NadavBenda/robotic-backgammon/pc/README.md

# PC side

Talks to `firmware/board` over USB serial (no Wi-Fi). Needs `pip install pyserial opencv-python numpy` (and `torch` for the pixel network of train_detector.py, optional).

**Folder:** the top level holds only the scripts you run (double-click) and their data
(`calib.json`, `layout.json`, `vision_model.json`, `captures/`, `games/`). All internal code is in
`lib/`; each script adds `lib/` to the import path by itself, so nothing else is needed.

| run this | for |
|---|---|
| `game.py` | a whole game, in the browser |
| `console.py` | type commands to the board (H, G x y, M 1, C, ?) |
| `calibrate.py` | camera calibration (`test` mode: click -> the magnet goes there) |
| `teach_layout.py` | fit the board map to the real board in 4 clicks |
| `place_opening.py` | set up the opening position with the cart showing where |
| `place_trays.py` | put all 30 checkers in the bear-off trays, the cart showing where |
| `arrange_opening.py` | the robot sets up the opening from the trays by itself |
| `collect.py` | labelled photos for checker detection: the robot moves checkers (columns, bar, bear-off trays; mostly where the dataset is thin) and photographs each position (saved in dataset/, not uploaded) |
| `train_detector.py` | teaches the learned checker detector from those photos, compares it with norm, saves detector.json (used only when vision = learned) |
| `move.py` | move single checkers by clicking, with planned paths |
| `swap.py` | demo: swap two checkers |
| `drag_test.py` | find the fastest drag speed that holds |
| `capture.py` | take photos |

The list below describes every file; the ones not in the table above are in `lib/`.

- `board.py`: `Board` class. Each call sends one command and waits for `DONE` (or raises `BoardError` on `ERR` / timeout), so commands never overlap. Units are mm.
- `console.py`: **the single place to control the board** (instead of the Serial Monitor). Type `H`, `G 100 200`, `M 1`, `C`, `?`; `C` saves and shows the photo. Normal mode shows results and warnings; type the toggle word (`DEV_TOGGLE` at the top, default `dev`) for developer mode with every board log line and timings.
- `gnubg.py`: GNU Backgammon as the move engine. `best_move(board, dice)` takes the 26-number board (`set board simple` format, from the side on roll) and returns `[Step(frm, to, hit)]` (BAR=25, OFF=0). `hit=True` = move the opponent checker to the bar first. Path to `gnubg-cli.exe` and strength (`PLIES`) at the top.
- `calibrate.py` + `lib/calib.py`: camera calibration by the robot itself. One checker rides on the magnet over a 6x6 grid; at each point a photo is taken and the checker found (Hough circle, you confirm with Enter or click). The green ellipse is where the round bottom of the checker should appear there: click so it sits on the bottom. Fits pixel <-> mm (lens distortion + perspective + mirror) into `calib.json` and prints the error. `py calibrate.py test`: click a checker in the photo and the magnet goes there.
- `swap.py`: finds two checkers in a photo and swaps them through a free spot beside them (A -> spot, B -> A, spot -> B), for a demo. `--times 6` swaps back and forth, `--auto` skips the window when exactly two are found. Stops `--overshoot 3` mm past the target before letting go; `--wiggle 3` makes a small circle after grabbing.
- `drag_test.py`: click a checker and a target; drags it once per profile, alternating A->B / B->A, at 120/160/200/250 mm/s and 300/800 mm/s^2 (skips higher accelerations once one fails), and after each drag shows a photo where you click the checker (no automatic detection), then lets you test the next checker. Prints a table per checker (+ `captures/drag_test.csv`) and leaves the fastest profile that held for all of them set on the board.
- All scripts home only when the board says `HOMED 0` (after a reset). Speeds live only in the firmware: drag (magnet on) 180 mm/s, 800 mm/s^2; free (magnet off) 150 mm/s, 1200 mm/s^2 from a 40 mm/s start; `M 0` waits 250 ms so a checker is let go before the next move. Change them without flashing with `P v a` / `F v a` in console.py (until reset).
- `paths.py`: `plan(start, goal, others)` returns the corners of a drag path whose checker keeps 30 mm (centre to centre) from every other checker (A* on a 5 mm grid, then corners cut, so usually 1-3 straight lines); `drag(b, path)` drives it with the magnet on and a 3 mm overshoot. Raises `NoPath` when the checkers block every way.
- `place_opening.py`: sets up the opening with no graphics on the glass: the cart drives under each place, you put a checker above it and press Enter, the magnet pulses to centre it.
- `move.py`: click all checkers once, then pick a checker and a goal; shows the planned path, drives it, and you click where it landed. Counts moves within 5 mm and moves that disturbed a neighbour (the 10/10 test).
- `helpers.py`: photo, circle finder, the click window and magnet-on shared by the scripts.
- `ui.py`: text strip above the photo, the expected checker-bottom ellipse, and `keep_open()` so a double-clicked script waits for Enter at the end (also after an error).
- `capture.py`: press Enter to grab a JPEG (UXGA 1600x1200) into `captures/` and show it (corrected top view once calib.json exists).

```python
from board import Board
with Board() as b:          # finds the ESP32 port by itself, or Board("COM5")
    b.home()
    b.move(100, 200)
    b.magnet(True); b.move(150, 200); b.magnet(False)
    jpeg = b.capture()
```

## Playing a whole game (12.11)

`py game.py` (double-click) opens a page in the browser: the board, the dice, the buttons and the
settings. Real board if it is connected, otherwise a simulator (to try everything without hardware).
Also from a phone on the same WiFi (the address is printed).

| file | what | options inside |
|---|---|---|
| `game.py` | turns, dice, reading the human's move, end of game, log in `games/<date-time>/` | mode: robot vs human / robot vs robot (demo) / watch (two people, the robot checks); human move: Done button / automatic (waits until the board shows a legal move) / pick it on the page and the robot moves it |
| `webui.py` | the page + terminal fallback (n, d, 52, ...) | |
| `rules.py` | legal moves, simple engine, find the move between two boards | engine: gnubg / simple / random |
| `layout.py` | where each checker goes, in mm (points, bar, bear-off trays, dice zone, park spot) | defaults from plan v4 fitted to 410x420; `teach_layout.py` fits it to the real board in 4 clicks |
| `vision.py` | board from one photo: colour of the rim around the steel bottom | scan (default) / slots / hough, + closest legal board |
| `dice.py` | the roll | digital / typed / camera (bottom face, 7 - pips) |
| `executor.py` | a move -> drags: on a hit the hitter waits next to the blot, the blot goes to the middle of the bar, then the hitter goes in; bear-off tray, paths | route: A* -> tight A* -> lane -> straight; `arrange()` sets up a position |
| `sim.py` | fake board: checkers follow the magnet, photos drawn through a fake camera | |
| `board_art.py` | `board_art.svg`, the board graphics at 1:1 from layout.json | |
| `lib/tests/` | `py lib/tests/test_rules.py`, `py lib/tests/test_sim.py` (whole game in the simulator) | |
