NadavBenda/robotic-backgammon/electronics/wiring_table.xlsx

Sheet: ESP32-S3
פין | אות | מחובר אל | צבע | הערה
GPIO 1 | X STEP | RJ45 → Shield D2 | כחול-לבן
GPIO 2 | X DIR | RJ45 → Shield D5 | כחול | LED כחול מהבהב, תקין
GPIO 41 | Y STEP | RJ45 → Shield D3 | חום-לבן
GPIO 42 | Y DIR | RJ45 → Shield D6 | חום
GPIO 21 | EN | RJ45 → Shield D8 | ירוק-לבן | LOW = מנועים פעילים
GPIO 39 | LIMIT X | RJ45 → מפסקי X- (2 בטור) | כתום-לבן | INPUT_PULLUP
GPIO 40 | LIMIT Y | RJ45 → מפסק Y- | כתום | INPUT_PULLUP
GPIO 47 | MAG | RJ45 → AOD4184 PWM | ירוק | PWM
GPIO 38 | VIO | בננה → Shield 5V pin | אדום | לוגיקת הדרייברים, 0.6mA. HIGH ראשון ב-setup
GND | GND | בננה → Shield GND | שחור | אדמה משותפת
USB-C | מתח + נתונים | מאריך 0.5 מ' → שקע בשפת המכסה → PC | אפור | אין 5V מהקופסה
FPC | מצלמה | OV3660, 75 מ"מ

Sheet: RJ45 + בננה
מס' גיד (T568B) | צבע | אות | ESP (מכסה) | יעד (קופסה)
1 | כתום-לבן | LIMIT X | GPIO 39 | מפסקי X-
2 | כתום | LIMIT Y | GPIO 40 | מפסק Y-
3 | ירוק-לבן | EN | GPIO 21 | Shield D8
4 | כחול | X DIR | GPIO 2 | Shield D5
5 | כחול-לבן | X STEP | GPIO 1 | Shield D2
6 | ירוק | MAG | GPIO 47 | AOD4184 PWM
7 | חום-לבן | Y STEP | GPIO 41 | Shield D3
8 | חום | Y DIR | GPIO 42 | Shield D6
בננה 1 | אדום | 3.3V | GPIO 38 | Shield 5V pin
בננה 2 | שחור | GND | GND | Shield GND

Sheet: CNC Shield V3
פין | אות | מחובר אל | צבע | הערה
D2 | X STEP | ESP GPIO 1 | כחול-לבן
D5 | X DIR | ESP GPIO 2 | כחול
D3 | Y STEP | ESP GPIO 41 | חום-לבן
D6 | Y DIR | ESP GPIO 42 | חום
D8 | EN | ESP GPIO 21 | ירוק-לבן
5V pin | VIO 3.3V | ESP GPIO 38 (בננה) | אדום | לא לחבר 5V!
GND (לוגיקה) | GND | ESP GND (בננה), AOD4184 GND, מפסקי גבול | שחור | נקודת אדמה משותפת
מחבר 12V + | 12V | שקע DC בפאנל + AOD4184 + | אדום | פיצול בבורג
מחבר 12V − | GND | שקע DC בפאנל + AOD4184 − | שחור | פיצול בבורג
X driver | מנוע | מנוע ימני | אפור | לפי Instructables
Y driver | מנוע | מנוע שמאלי | אפור

Sheet: AOD4184
פין | אות | מחובר אל | צבע | הערה
PWM | MAG | ESP GPIO 47 | ירוק | אופטו PC817C, עובד מ-3.3V. לא צריך נגד 10k
GND | GND (אות) | Shield GND (= GND של ה-ESP) | שחור | מבודד מ-−, לא לקצר
+ | 12V | מחבר 12V של ה-Shield, וגם + של האלקטרומגנט | אדום | שני חוטים באותו בורג
− | GND | מחבר 12V של ה-Shield (−) | שחור
LOAD | מיתוג | הרגל השנייה של האלקטרומגנט | שחור | 1N4007 על המגנט: פס ל-+

Sheet: מפסקי גבול
מפסק | רגל | מחובר אל | צבע | הערה
X- (זוג בטור) | COM של הראשון | ESP GPIO 39 (RJ45) | כתום-לבן | NO, בטור: מופעל רק כששניהם לחוצים
X- (זוג בטור) | NO של הראשון → COM של השני | בין המפסקים
X- (זוג בטור) | NO של השני | Shield GND | שחור
Y- | COM | ESP GPIO 40 (RJ45) | כתום
Y- | NO | Shield GND | שחור

Sheet: מפת פינים ESP
GPIO | מצב | שימוש
4–13, 15–18 | אסור | מצלמה
35–37 | אסור | Octal PSRAM
19, 20 | אסור | USB
0, 3, 45, 46 | להימנע | Strapping
43, 44 | להימנע | UART0
48 | להימנע | RGB LED
1, 2, 41, 42 | תפוס | מנועים
21 | תפוס | EN
39, 40 | תפוס | מפסקי גבול
47 | תפוס | מגנט
38 | תפוס | VIO דרייברים
14 | פנוי
