NadavBenda/robotic-backgammon/electronics/wiring.md

# חיווט: AI-bg

הגרסה הנוכחית (4.11.2026) נמצאת ב-`wiring_table.xlsx` (טבלה לכל כרטיס) וב-`wiring_diagram.png` (שרטוט).

סיכום ההחלטות (grill 4.11):
- ה-ESP מקבל מתח ונתונים מה-PC דרך USB-C. מאריך 0.5 מ' עד שקע בשפת המכסה. אין 5V מהקופסה, וה-Mini360 יצא מהמערכת.
- בין המכסה לקופסה: כבל רשת עם RJ45 coupler לאותות, ומחבר בננה 2-pin ל-3.3V ו-GND.
- VIO של ה-Shield (פין 5V) מקבל 3.3V מ-GPIO 38 של ה-ESP (מ-8.11; 0.6mA נמדד), ולא 5V. הקוד מדליק את 38 ראשון ב-setup.
- מפסקי גבול: X- = שני NO בטור על GPIO 39, ו-Y- על GPIO 40. המגנט על GPIO 47 (צמוד ל-EN על 21). מודול ה-AOD4184 מבודד (אופטו PC817C), עובד מ-3.3V, ולא צריך נגד 10k.
- פיצול ה-12V נעשה בבורג של ה-Shield, בלי Wago. אין נתיך ואין מתג: חיבור השקע בפאנל מדליק את המערכת.
- 1N4007 על המגנט, פס ל-+.
