NadavBenda/robotic-backgammon/electronics/wiring_diagram.png

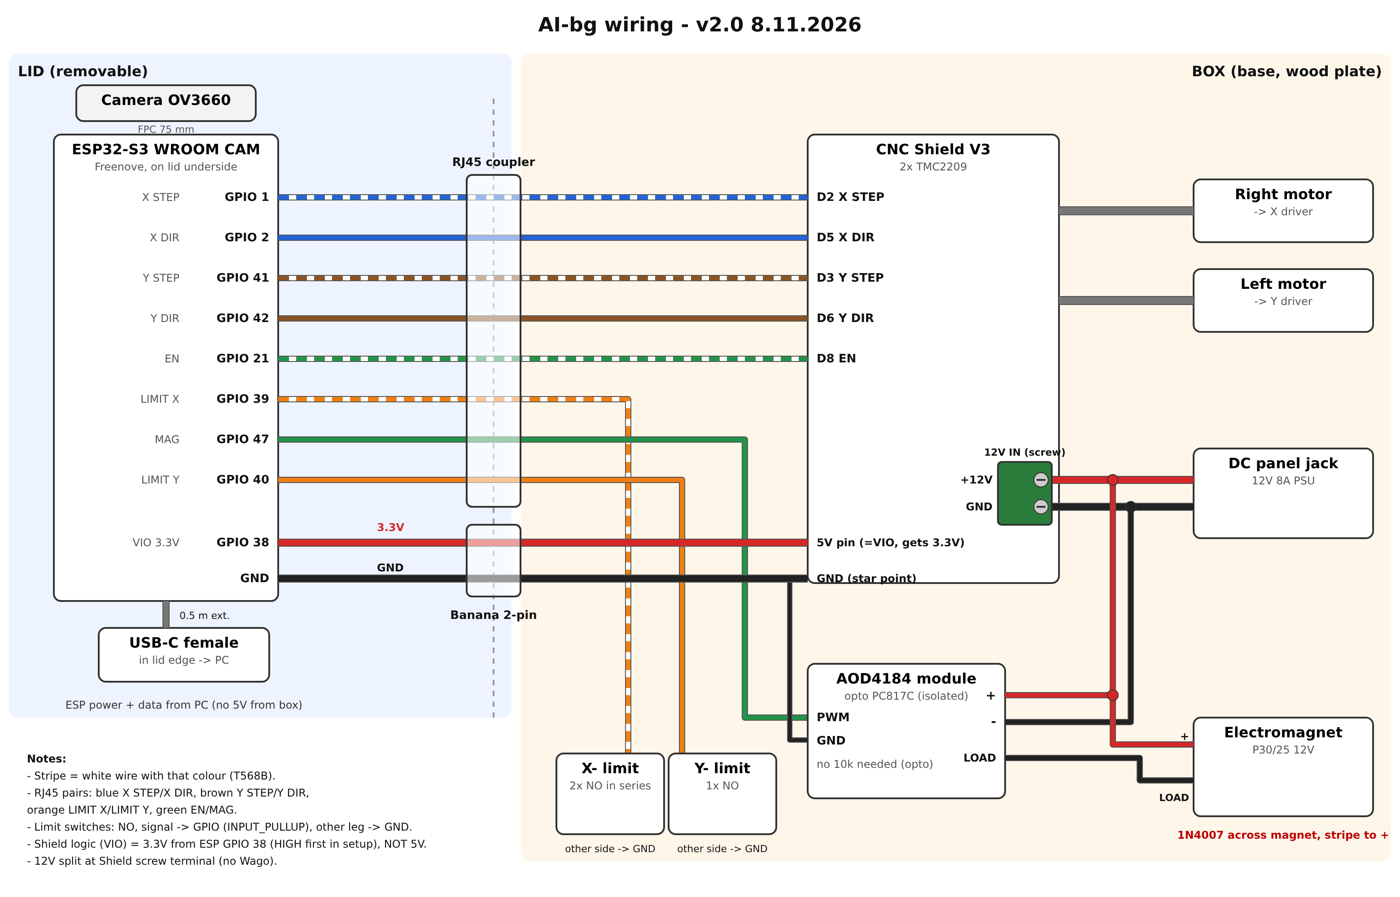
electronics/wiring_diagram.png
