NadavBenda/robotic-backgammon/(commit log)

2026-10-15 Add ESP32 firmware sketches (#1)
    Add circle_motors, home_LS and move_XY_using_serial sketches from the local ESP32 code folder, plus a short README with pins and serial commands.
    Claude-Session: https://claude.ai/code/session_01BqSRANh45VkKz8L2vsyHC4
2026-11-04 Move limit switches to GPIO 39/40 (15/16 are camera pins) (#2)
    Claude-Session: https://claude.ai/code/session_015WaiVMX3WZxhdmsv3QW5E3
2026-11-06 Add serial command to switch the electromagnet (#3)
    * Move limit switches to GPIO 39/40 (15/16 are camera pins)
    * Add M command to switch the electromagnet on GPIO 14
    ---------
    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
2026-11-06 Move electromagnet pin to GPIO 47 (#4)
    * Move electromagnet pin to GPIO 47 (next to EN on 21)
    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
2026-11-06 Add Magnet class with on-time timeout and heat budget (#5)
    Claude-Session: https://claude.ai/code/session_015WaiVLR25ZLCtFkV82XqwE
2026-11-06 Add BoardCheck.h: fail compile on wrong Arduino Tools settings (#6)
    * Add Magnet class with on-time timeout and heat budget
    * Add BoardCheck.h: fail compile on wrong Arduino Tools settings
    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
2026-11-07 Add board firmware (motion + magnet + camera over USB) and PC client (#7)
    * Add board firmware (motion + magnet + camera over USB, DONE/ERR protocol) and PC client
    Co-authored-by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
2026-11-07 Add PC console with normal/developer modes; warn on capture with magnet on (#8)
    * Add PC console wi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
2026-11-07 Add gnubg.py: GNU Backgammon move engine wrapper (#9)
    * Add PC console with normal/developer modes;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
2026-11-08 Power driver logic (Shield VIO) from GPIO 38 (#10)
    * Power driver logic (Shield VIO) from GPIO 38
    GPIO 38 is driven HIGH first in setup(),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
2026-11-08 Add wiring diagram and table (v2.0) (#11)
    GPIO 38 is driven HIGH first in setup(), before ST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
2026-11-09 Raise electromagnet max on-time from 10 s to 40 s (#12)
    * Add PC console with normal/developer mode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
2026-11-09 Set soft limits to the measured board edge (415 mm) (#13)
    * Add PC console with normal/developer mo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
2026-11-09 Homing: back off slowly until the limit switch releases (#14)
    * Add PC console with normal/develope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
2026-11-11 Add camera calibration by the robot (calibrate.py, calib.py) (#15)
    * Add PC console with normal/dev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
2026-11-11 calibrate: park the magnet away before each photo (#16)
    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
2026-11-11 calibrate: step aside 80 mm instead of going to a far corner (#17)
    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
2026-11-11 pc: swap.py, find two checkers and swap them (#18)
    * Add PC console with normal/developer modes; wa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
2026-11-11 Drag profile while the magnet is on, overshoot, bottom ellipse, readable windows (#19)
    * Add PC con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
2026-11-11 Drag profile default 120 mm/s, 300 mm/s²; P accepts up to 200 mm/s (#20)
    * Add PC console with nor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
2026-11-11 pc: drag_test.py, find the fastest drag profile that holds the checker (#21)
    * Add PC console with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
2026-11-11 Board edge x 410, y 420; shorter drag_test (#22)
    * Add PC console with normal/developer modes; warn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
2026-11-11 Home only when needed, park at 5,5 on close, faster drag_test (#23)
    * Add PC console with normal/de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
2026-11-11 drag_test: tolerance 30 mm, retry photo from park, save photos (#24)
    * Add PC console with normal/d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
2026-11-11 drag_test: click the checker after each drag; no park at 5,5 on close (#25)
    * Add PC console with n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
2026-11-11 drag_test: one drag per profile, alternating direction (#26)
    * Add PC console with normal/developer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
2026-11-11 drag_test: speeds 120-250, accels 300/800 (#27)
    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
2026-11-12 Drag paths that avoid other checkers (paths.py) + move test (move.py) (#28)
    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
2026-11-12 Release delay and two speed profiles in firmware (#29)
    * Add PC console with normal/developer modes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
2026-11-12 Whole game: rules, layout, vision, dice, executor, simulator, game page (#30)
    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
2026-11-12 sim: hand placement never overlaps another checker (#31)
    * Add PC console with normal/developer mod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
2026-11-12 Drag default 180/800 (firmware + PC) (#32)
    * Add PC console with normal/developer modes; warn on ca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
2026-11-12 place_opening.py: robot shows where each opening checker goes (#33)
    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
2026-11-12 Longer grab/release, top-down view after calibration (#34)
    * Add PC console with normal/developer m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
2026-11-12 capture.py: main guard (#35)
    * Add PC console with normal/developer modes; warn on capture with mag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
2026-11-12 Top view in every photo window, UXGA camera, roomier drag paths (#36)
    * Add PC console with normal/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
2026-11-12 Tidy pc/: scripts at the top, internal code in pc/lib (#37)
    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
2026-11-12 Release kick after M 0, calibration error map, park for calibration photos (#38)
    * Add PC console w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
2026-11-12 Round the corners of drag paths into short arcs (#39)
    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
2026-11-12 Corners: one short cut instead of a 3-point arc (#40)
    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
2026-11-12 Retake broken camera frames (#41)
    * Add PC console with normal/developer modes; warn on capture wit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
2026-11-12 Restore helpers.find_circles; test that every script imports (#42)
    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
2026-11-12 calibrate: grid from 0,0 to the travel limits (#43)
    * Add PC console with normal/developer modes; w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
2026-11-12 Release: overshoot 5 mm, back onto target, settle 0.4 s (#44)
    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
2026-11-12 Photo park spot: lane centre at y max (#45)
    * Add PC console with normal/developer modes; warn on c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
2026-11-12 All scripts park at (205, 420) for photos (#46)
    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
2026-11-12 Magnet-off moves go around the checkers (#47)
    * Add PC console with normal/developer modes; warn on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
2026-11-12 Vision: "norm" method as game default; save images on Hebrew paths (#48)
    * Add PC console with norm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
2026-11-12 Vision: read moves by change; auto camera-shift fix (#49)
    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
2026-11-12 Vision: safer camera shift and read-by-change acceptance (#50)
    * Add PC console with normal/develop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
2026-11-12 game: Learn colours button when needed (#51)
    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
2026-11-12 Hit order, bar in the middle, fix the reading on the page (#52)
    * Add PC console with normal/develo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
2026-11-13 norm: one colour per point, bar/off colour by place (#53)
    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
2026-11-13 CH: one full-resolution (QXGA) capture (#54)
    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
2026-11-13 calibrate: short step aside (40 mm out in y) for each photo (#55)
    * Add PC console with normal/deve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
2026-11-13 calibrate: good guess from the first point (#56)
    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
2026-11-13 calibrate: y≈0 row steps 40 mm inward (#57)
    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
2026-11-13 calibrate: photo position as before 12.11 (#58)
    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
2026-11-13 place_opening: go around placed checkers (#59)
    * Add PC console with normal/developer modes; warn o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
2026-11-13 collect.py: robot-made labelled photos for checker detection (#60)
    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
2026-11-13 Learned checker detector: train_detector.py + lib/learned.py (#61)
    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
2026-11-13 Pixel network (PyTorch) that also gets the computed features (#62)
    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
2026-11-13 Magnet-off travel keeps more room from checkers (#63)
    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
2026-11-13 Circle detection as a detector input + pixels-only control (#64)
    * Add PC console with normal/devel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
2026-11-13 Board drawing over every corrected top view (#65)
    * Add PC console with normal/developer modes; war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
2026-11-13 collect.py: show the next drag before each move (#66)
    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
2026-11-13 train_detector: mistake breakdown, seed spread, both nets together (#67)
    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
2026-11-13 collect: detector second opinion, moves where data is thin, bar and trays; lighter board drawing (#68)
    Claude-Session: https://claude.ai/code/session_015WaiVLR25ZLCtFkV82Xq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
2026-11-13 collect: the robot puts a pushed checker back by itself (#69)
    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
2026-11-13 Fewer stops per path; collect: mark what moved, crash log, state before each drag (#70)
    * Add PC co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
2026-11-13 Training stops early; quick training by default; sharp corners cost like any corner (#71)
    * Add PC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
2026-11-14 Game: vision default learned; only learned and norm offered; quick training trains learned only (#72)
    Claude-Session: https://claude.ai/code/session_015WaiVLR25ZLCtFkV82Xqw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
2026-11-14 place_trays.py and arrange_opening.py: from the bear-off trays to the opening (#73)
    * Add PC consol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
2026-11-14 arrange_opening: fill like a person, farthest columns first, edge checker first (#74)
    * Add PC cons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
2026-11-14 Fix detector.json loading; cool the magnet before a drag (#75)
    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
2026-11-14 Corner waits, softer drag accel, turn-priced routes, heat budget x1.5 (#76)
    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
2026-11-14 Edit screen: checkers stacked like a real board (#77)
    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
2026-11-14 Game page: plainer status, settings and raw photo folded, no move list (#78)
    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
2026-11-14 Game page: board in the camera view's orientation, animated dice (#79)
    * Add PC console with normal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
2026-11-14 PC code folder: data files move into data/ (#80)
    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
2026-11-14 Game page draws checkers in their real colours (#81)
    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
2026-11-14 arrange_opening: empty the outer bear-off row first (#82)
    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
2026-11-14 Page checkers: black and white only (#83)
    * Add PC console with normal/developer modes; warn on cap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
2026-11-14 Defaults: person starts first; red and blue as default colours (#84)
    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
2026-11-14 Bar on the centre line, colour swap, big Done button, arrange from the bottom up (#85)
    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
2026-11-14 collect saves the calibration with each run; training uses it (#86)
    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
2026-11-14 Longer straight start of a drag, higher cost per turn, click editing of the board (#91)
    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
2026-11-14 Game: a checker the detector keeps missing stays where the known board has it (#92)
    Places that did not change since the last photo keep the known (confirmed or page-fixed)
    count when the detector sees fewer of that colour there.
    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
2026-11-14 Paths keep away from the limit switches at x=0 / y=0; a LIMIT error homes and retries (#93)
    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
2026-11-14 Home boards at the far side (by the camera), bear-off trays stay (#94)
    Layout.homes_far (default True) puts points 1-6 / 19-24 at the far end and
    12/13 next to the trays. change_cost ignores an empty slot that overlaps a
    slot that should change (a point's 8th place next to the bar column).
    Claude-Session: https://claude.ai/code/session_015WaiVHnSrhc467dEoUEcPm
2026-11-14 collect_endgame.py: collect photos with full home boards (#96)
    Same as collect.py, but 85% of the column moves go into the mover's home,
    more bear-offs, fewer hits; runs are saved as dataset/<time>-endgame.
    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
2026-11-14 Game page: the drawn board is flipped vertically (#98)
    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
2026-11-14 Game page: camera photos flipped vertically too, like the drawing (#99)
    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
2026-11-14 diag_detector.py: is the detector learning colour from position? (#100)
    learned.POS_PRESENCE / POS_COLOUR (both True, as before) let the networks be
    trained without the slot's position; diag_detector.py compares the variants
    leave-one-run-out and prints how one-sided each column is in the dataset.
    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
2026-11-14 collect: more off-centre placements (60% of moves, 3-9 mm) (#102)
    The detector misread hand-placed checkers; collect photos were too tidy.
    11 mm made the robot push neighbours in the simulator, 9 mm does not.
    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
